codesteller/vedyne-pcb/README.md

# vedyne-pcb
This repository is a KiCad PCB Design for Gahan AI's Vedyne Board, which is an STM32F103C8T6 microcontroller based board housing a GNSS, IMU and CAN interfaces with Bluetooth communication
