codesteller/vedyne-pcb/STM32_BT_IMU/629105150521_rev1.stp

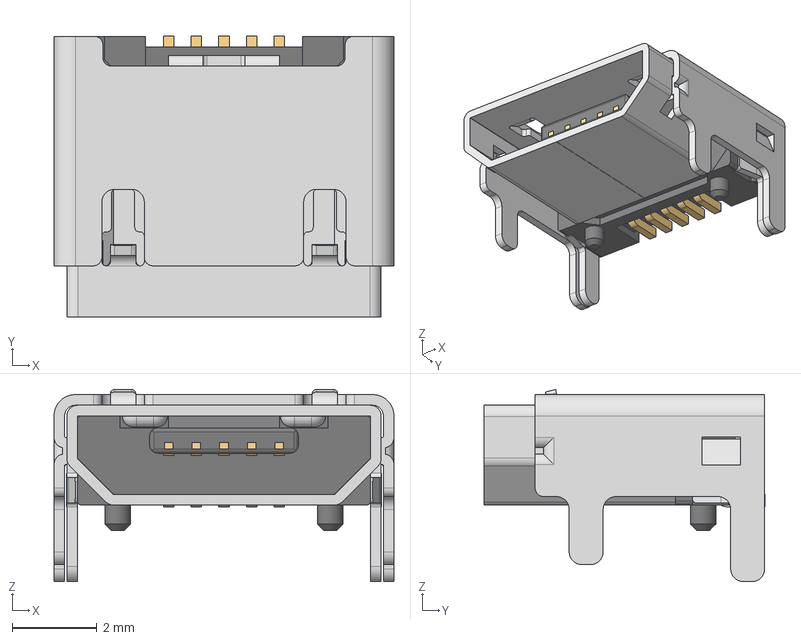
[picture p1: CAD file, 2025-02-10]
STM32_BT_IMU/629105150521_rev1.stp
8.00 x 6.60 x 4.52 mm
629105150521_Housing
629105150521_Pin1 x 4
629105150521_Pin2
629105150521_Shielding2
629105150521_Shielding
