codesteller/vedyne-pcb/(commit log)

2025-02-10 Add STM32_BT_IMU directory
    [STM32_BT_IMU.kicad_pcb, STM32_BT_IMU.kicad_sch]
2025-02-10 Added crystal
    [STM32_BT_IMU.kicad_sch]
2025-02-10 added can controller
    [STM32_BT_IMU.kicad_sch]
2025-02-10 Added UART and I2C in Scematics
    [STM32_BT_IMU.kicad_sch]
2025-02-10 Added CAN in Schematics
    [STM32_BT_IMU.kicad_sch]
2025-02-10 Added Footprints
    [STM32_BT_IMU.kicad_sch]
2025-02-10 Layout done
    [629105150521_rev1.stp, STM32_BT_IMU.kicad_pcb, STM32_BT_IMU.kicad_sch]
2025-02-15 pcb layout started
    [STM32_BT_IMU.kicad_pcb, STM32_BT_IMU.kicad_sch]
